murr2k/scope-clock/(commit log)

2026-08-26 Initial commit: X-Y oscilloscope vector clock
    Draws a clock on an analog oscilloscope in X-Y mode, where the scope acts as a
    vector display. A timer-paced pair of circular DMA streams emits one beam
    sample per tick, so the picture costs zero CPU once running; the compositor
    only rebuilds a frame on the 1 Hz tick or a mode/message change and swaps it at
    a frame boundary so it never tears.
    Verified running on a NUCLEO-G491RE: 200 kSa/s, 2097-point analog face at 95 Hz
    refresh. Confirmed live over SWD rather than by eye - DAC_CR, TIM6 ARR, DMA
    CNDTR counting down, and streamed samples decoding to the correct face radius.
    Four board targets share the engine, scenes and font; only the output ba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
    [analog.py, board.h, board_f401.h, board_f407.h, board_g431.h, board_g491.h, check_c_engine.py, dac_dma.c]
2026-08-26 Z-blank: drive a Keysight InfiniiVision directly, active-low
    In XY mode the InfiniiVision reassigns EXT TRIG IN as the Z (blanking) input,
    and its polarity is the opposite of a typical CRT bright-up input. From the
    4000 X-Series user's guide p74: "When Z is low (<1.4 V), Y versus X is
    displayed; when Z is high (>1.4 V), the trace is turned off."
    So board_g491.h now sets ZBLANK_ACTIVE_HIGH 0. Verified in the live frame
    buffer on hardware: lit samples emit BSRR 0x00400000 (PB6 low), blanked emit
    0x00000040 (PB6 high).
    EXT TRIG IN is a 1 Mohm logic input switching at 1.4 V, so PB6 drives it
    directly at ~3 uA and Q1 is not needed at all on this scope - the whole clock
    becomes one IC and four w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
2026-08-26 Document the HITL scope procedure in CLAUDE.md
    Claude drives the scope directly on the bench rig, so the setup belongs where
    Claude actually loads it (CLAUDE.md, auto-read every session) rather than only
    in the human-facing hardware doc, which cross-references it now.
    Covers the verified wiring (CH1/CH2/EXT TRIG = X/Y/Z in XY mode), a copyable
    SCPI bring-up sequence, and screen capture via :DISPlay:DATA? PNG so the
    rendered clock can be looked at rather than inferred from register reads.
    Calls out the two DSO-specific steps whose absence mimics a firmware bug:
    infinite persistence (no phosphor, so without it the clock is a dot scatter)
    and an acquisition window spanning the full 10.5 ms fr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
